robzed/EEPROM_Reader/Documents/ICs_Pinouts.pdf

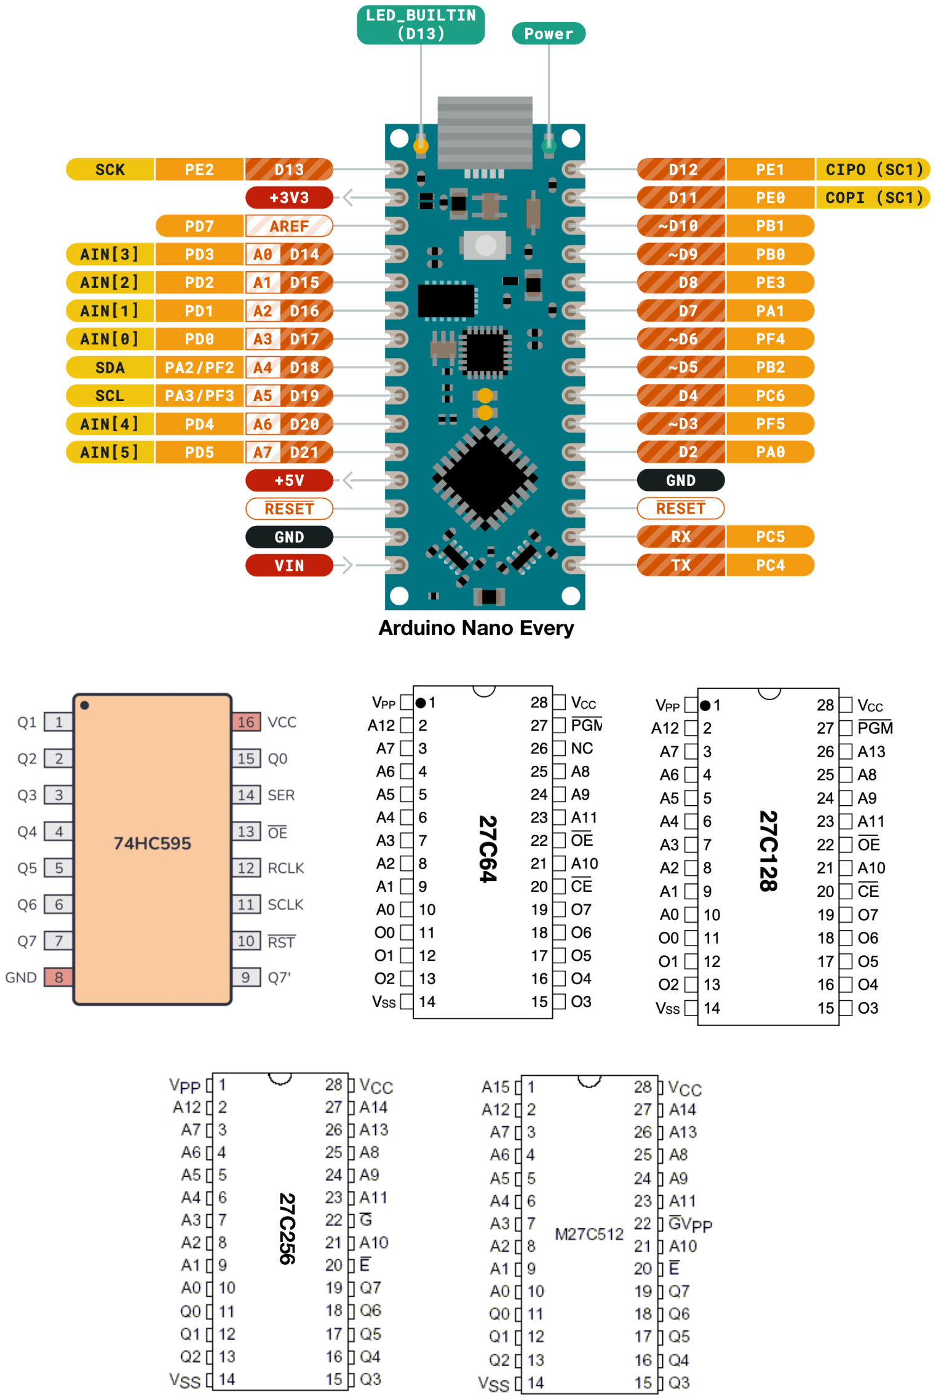
[picture p2: page 1]

Arduino Nano Every

27C256
