robzed/EEPROM_Reader/Hardware/Arduino_EEPROM_Reader.pdf

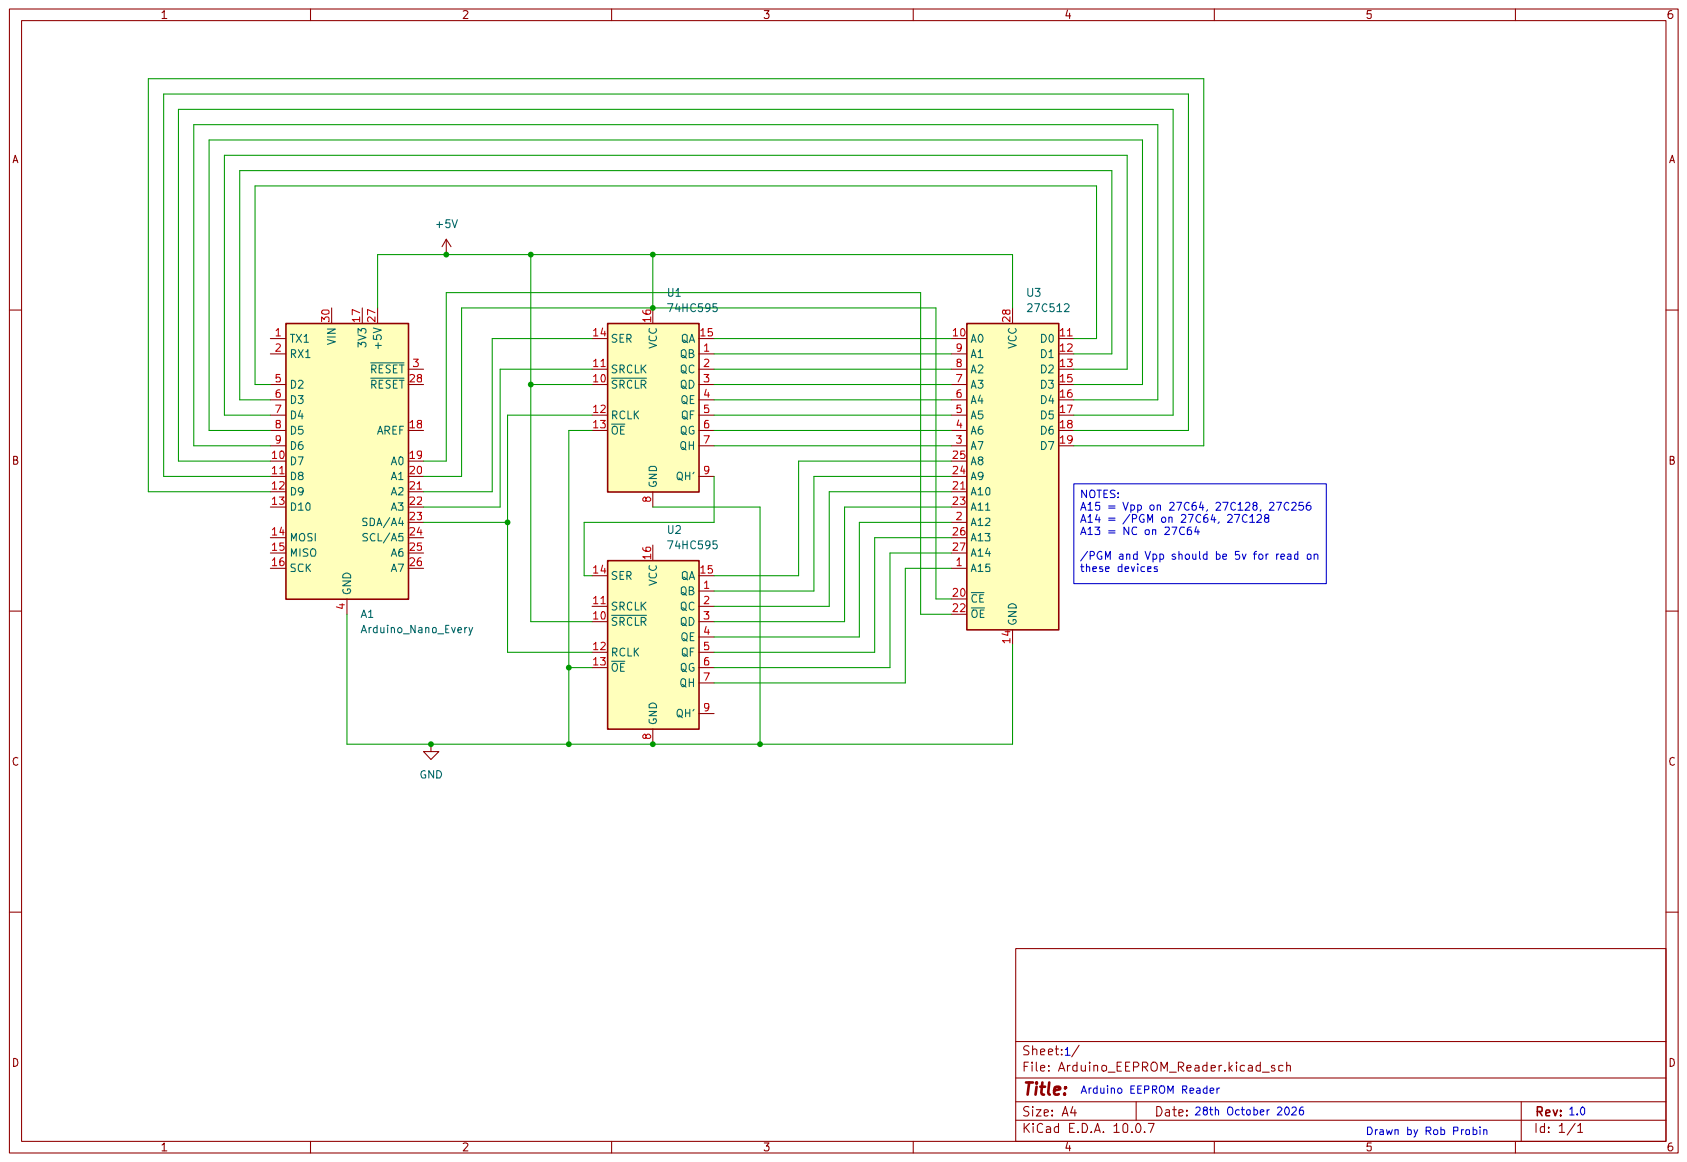
[picture p3: page 1]
