robzed/EEPROM_Reader/(commit log)

2026-10-28 Basic Hardware Design
    [Arduino_EEPROM_Reader.kicad_pcb, Arduino_EEPROM_Reader.kicad_sch]
2026-11-01 Fix items in schematic
    [Arduino_EEPROM_Reader.kicad_sch]
2026-11-05 First work in progress draft of Arduino software
2026-11-08 Leave source with GPIO for schematic version.
